cristibeldea/Arduino-Elevator/WhatsApp Image 2024-05-21 at 12.59.09 AM.jpeg

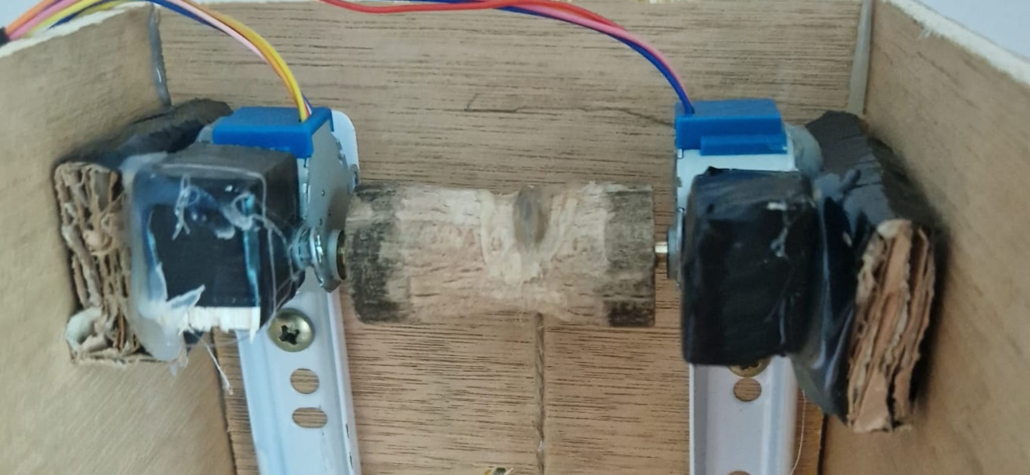
WhatsApp Image 2024-05-21 at 12.59.09 AM.jpeg
