cristibeldea/Arduino-Elevator/README.md

# Arduino-Elevator
A fully automatic Arduino elevator involving safety mechanisms, a DIY model and the possibility of stopping at each floor is called, while running.
